haya1010/esp32-c3-compact-dip-led/ORDER_REVIEW.md

# JLCPCB注文前レビュー

## 現在の検証結果

- KiCad ERC: 0エラー、0警告
- KiCad PCB DRC: 0違反、未配線0
- 2層、50 × 78 mm
- ESP32アンテナ下・前方は両面銅箔/配線/ビア禁止領域
- USB-C D+/D-は意図的に未接続
- USB-C CC1/CC2は各5.1 kΩでGND終端
- DC入力からLED+までは太配線、MOSFETはローサイド

## 注文画面で必ず確認する項目

1. 2層、FR-4 1.6 mm、1 oz銅、外形50 × 78 mm。
2. SMT実装面はTopのみ。
3. BOM/CPL照合画面でU1、U2、J2、Q1、L1の向きを画像と比較。
4. LCSC在庫切れ時に自動代替を承認しない。電圧・パッケージ・ピン互換を再確認。
5. Q1 RJP020N06T100（C703680）はNRND。在庫がなければ勝手に別MOSFETへ置換せず再設計。
6. L1はC49009349。22µH、定格2A、飽和3.1A、4.1×4.1mmであることを確認。
7. J1、J3、J4、JH1、JH2、JP1、JP2は手作業対象。
8. 最初は5枚、Economic PCBA、部品実装2枚程度で試作を推奨。

## 費用の目安

L1自体は低数量時で概ね **40～50円/個** の低価格品です。ただしExtended部品なので、部品単価とは別に実装時の固定費が発生する場合があります。

JLCPCBの在庫・セットアップ料金・送料で大きく変わります。5枚基板＋片面PCBA＋日本への通常配送で、概ね **4,000～8,000円** を想定してください。10～20枚に増やすと固定費が分散し、1枚1,000円未満を狙いやすくなります。DCジャック、端子台、ピンヘッダ、ACアダプタ、LEDテープは別です。正確な金額はアップロード後の見積画面でのみ確定します。

## 初回通電手順

1. JP1をDC側、JP2をREG側の片側だけ接続。
2. LEDとA105をまだ接続しない。
3. 電流制限を100 mA程度にした5 V電源をDCジャックへ接続。
4. JH1-2とGND間が約3.3 Vであることを確認。
5. 異常発熱がないことを確認後、ESP32、A105、LEDを順に試す。

この設計は試作未実機確認です。量産前に必ず初版を実測してください。
