haya1010/esp32-c3-compact-dip-led/previews/schematic.pdf

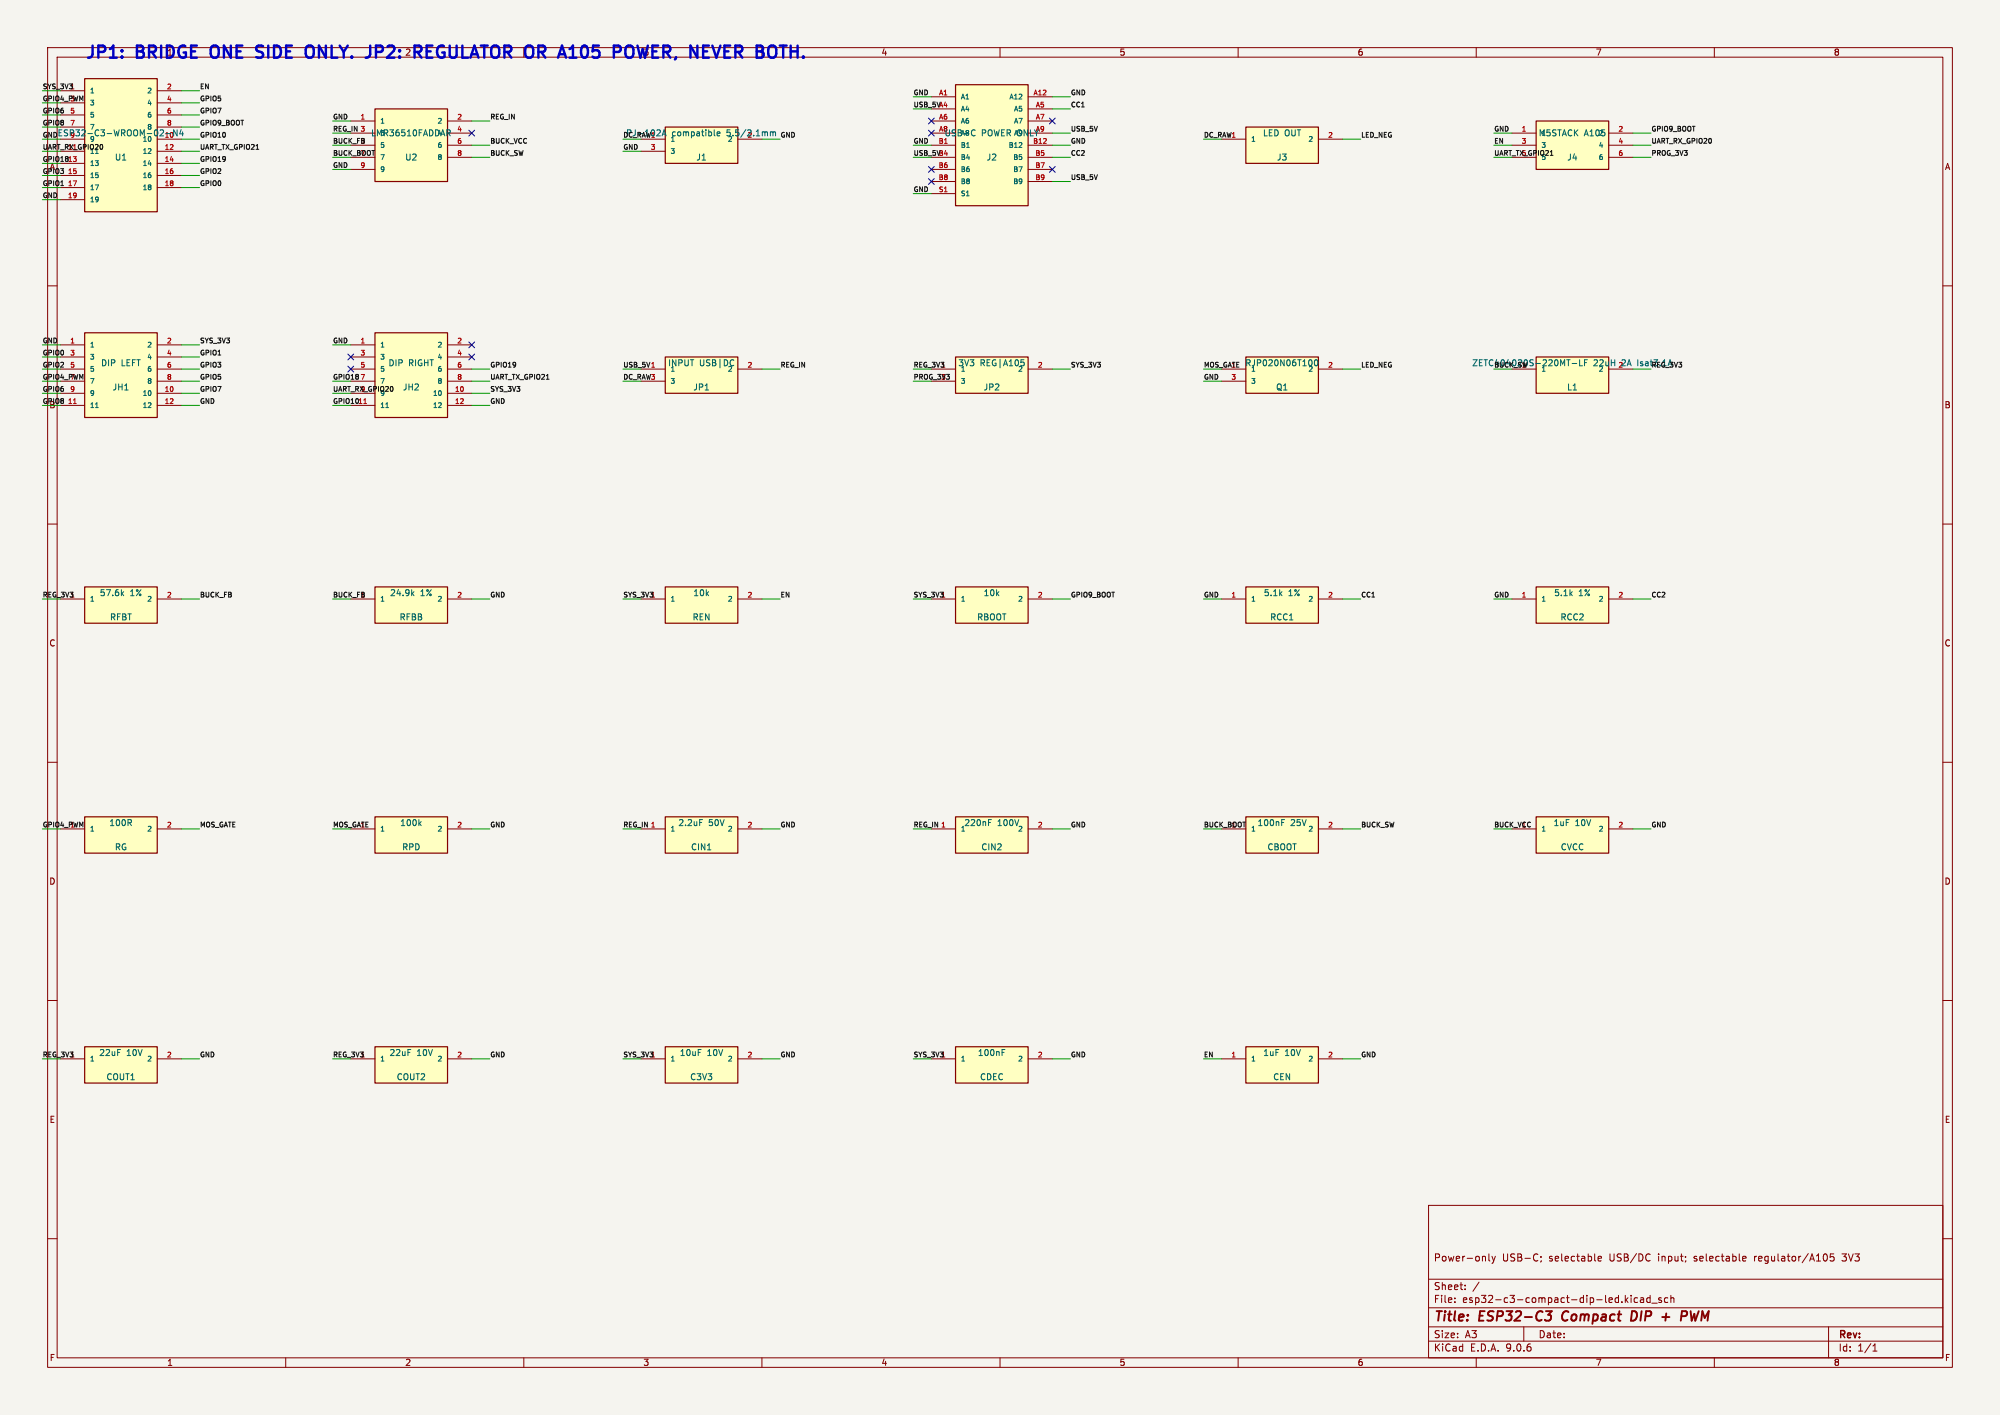
[picture p2: page 1]

UART_TX_GPIO21 JP1: BRIDGE ONE SIDE ONLY. JP2: REGULATOR OR A105 POWER, NEVER BOTH.
