haya1010/esp32-c3-compact-dip-led/esp32-c3-compact-dip-led.kicad_pcb

## KiCad design esp32-c3-compact-dip-led.kicad_pcb (2026-10-18)

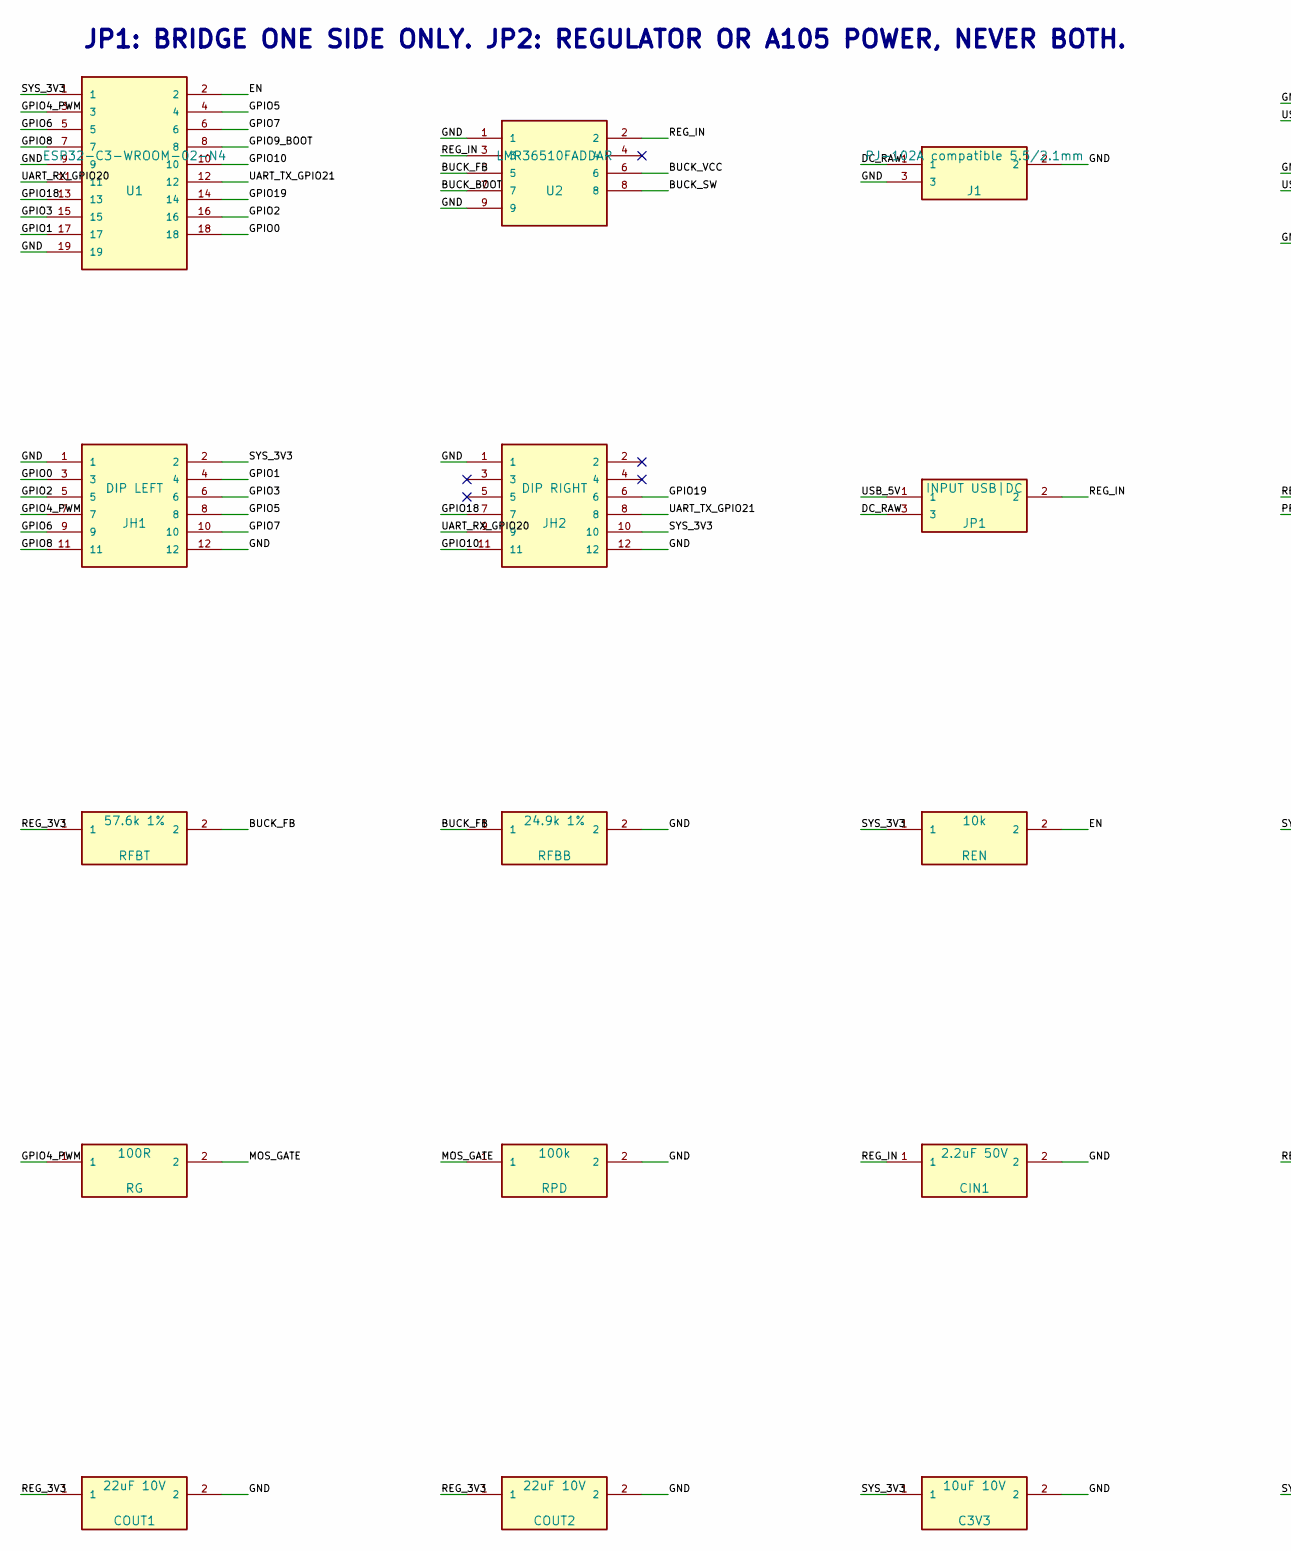
[picture p3: schematic esp32-c3-compact-dip-led.kicad_sch, ESP32-C3 Compact DIP + PWM, part in row 1, column 1]

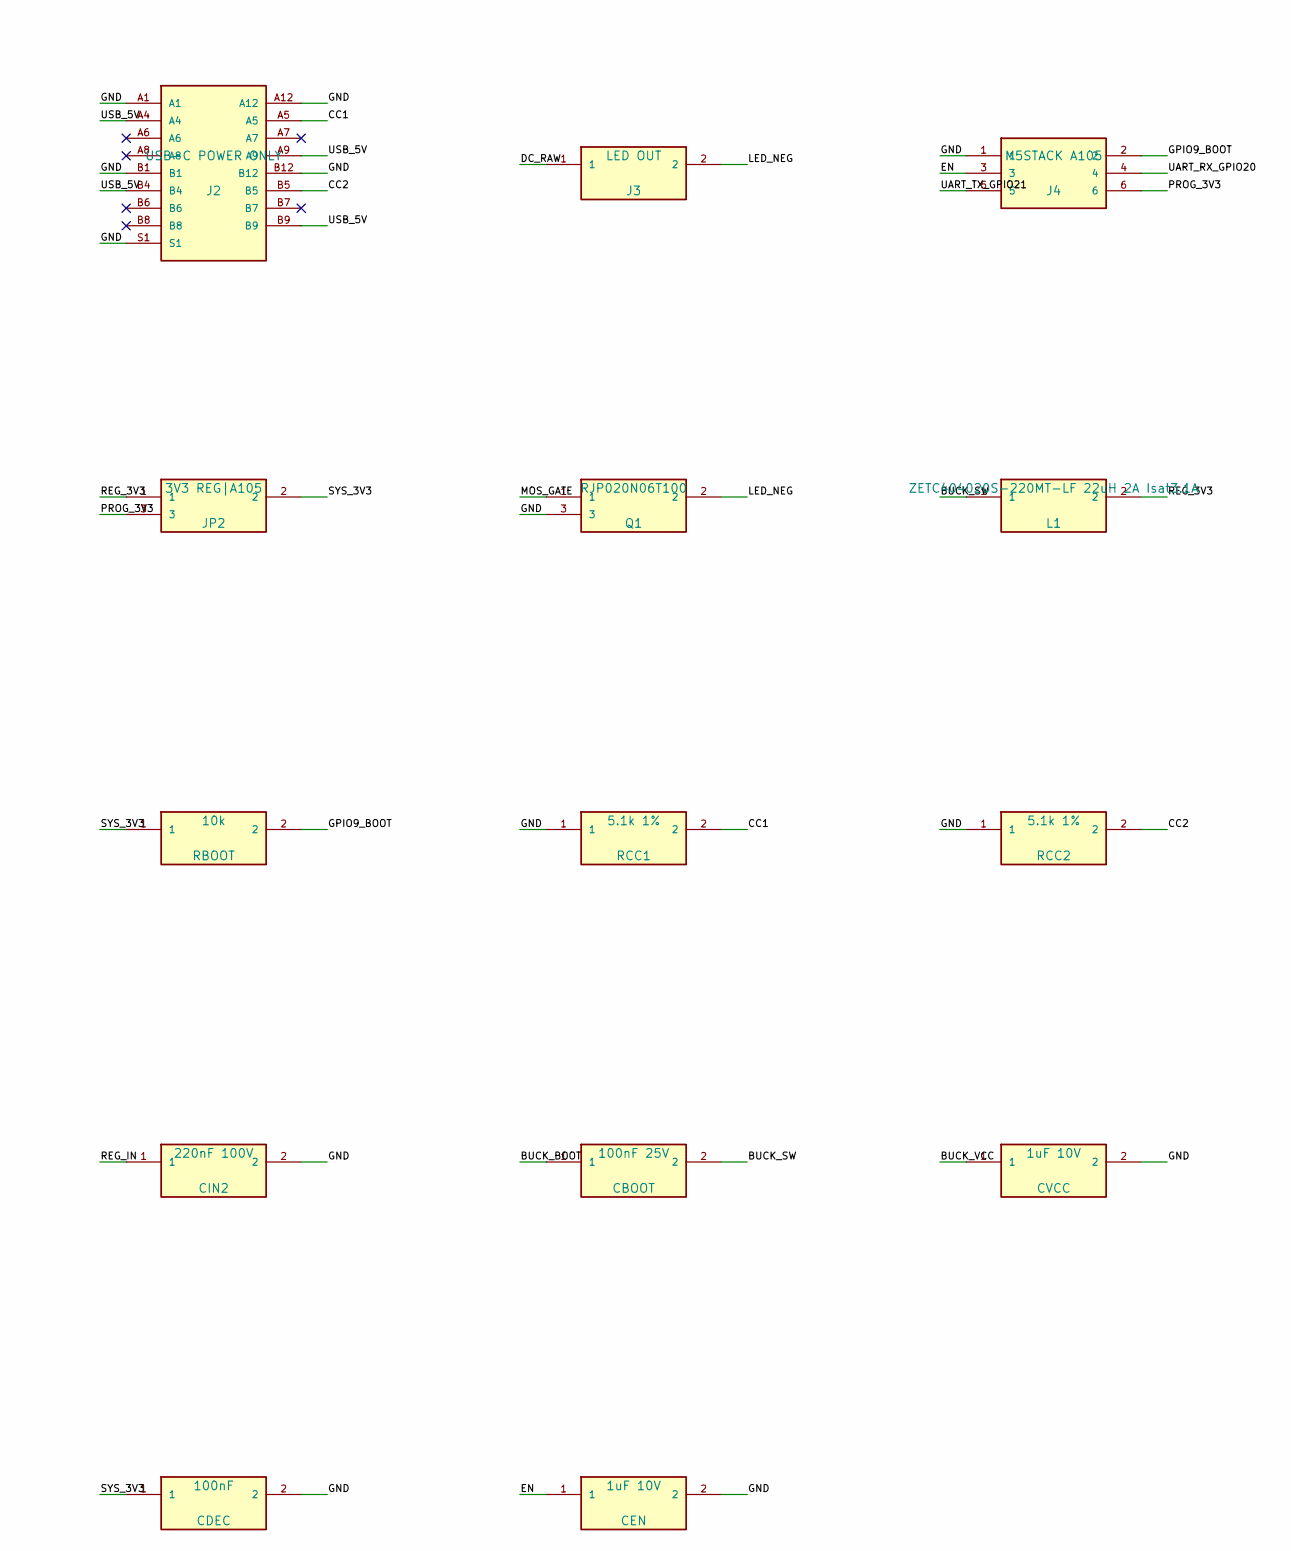
[picture p4: schematic esp32-c3-compact-dip-led.kicad_sch, ESP32-C3 Compact DIP + PWM, part in row 1, column 2]

Parts:
C3V3: 10uF 10V
CBOOT: 100nF 25V
CDEC: 100nF
CEN: 1uF 10V
CIN1: 2.2uF 50V
CIN2: 220nF 100V
COUT1, COUT2: 22uF 10V
CVCC: 1uF 10V
J1: PJ-102A compatible 5.5/2.1mm
J2: USB-C POWER ONLY
J3: LED OUT
J4: M5STACK A105
JH1: DIP LEFT
JH2: DIP RIGHT
JP1: INPUT USB|DC
JP2: 3V3 REG|A105
L1: ZETC404020S-220MT-LF 22uH 2A Isat3.1A
Q1: RJP020N06T100
RBOOT: 10k
RCC1, RCC2: 5.1k 1%
REN: 10k
RFBB: 24.9k 1%
RFBT: 57.6k 1%
RG: 100R
RPD: 100k
U1: ESP32-C3-WROOM-02-N4
U2: LMR36510FADDAR

Connections:
BUCK_BOOT: CBOOT.1, U2.7
BUCK_FB: RFBB.1, RFBT.2, U2.5
BUCK_SW: CBOOT.2, L1.1, U2.8
BUCK_VCC: CVCC.1, U2.6
CC1: J2.A5, RCC1.2
CC2: J2.B5, RCC2.2
DC_RAW: J1.1, J3.1, JP1.3
EN: CEN.1, J4.3, REN.2, U1.2
GND: C3V3.2, CDEC.2, CEN.2, CIN1.2, CIN2.2, COUT1.2, COUT2.2, CVCC.2, J1.2, J1.3, J2.A1, J2.A12, J2.B1, J2.B12, J2.S1, J4.1, JH1.1, JH1.12, JH2.1, JH2.12, Q1.3, RCC1.1, RCC2.1, RFBB.2, RPD.2, U1.9, U1.19, U2.1, U2.9
GPIO0: JH1.3, U1.18
GPIO1: JH1.4, U1.17
GPIO2: JH1.5, U1.16
GPIO3: JH1.6, U1.15
GPIO4_PWM: JH1.7, RG.1, U1.3
GPIO5: JH1.8, U1.4
GPIO6: JH1.9, U1.5
GPIO7: JH1.10, U1.6
GPIO8: JH1.11, U1.7
GPIO9_BOOT: J4.2, RBOOT.2, U1.8
GPIO10: JH2.11, U1.10
GPIO18: JH2.7, U1.13
GPIO19: JH2.6, U1.14
LED_NEG: J3.2, Q1.2
MOS_GATE: Q1.1, RG.2, RPD.1
PROG_3V3: J4.6, JP2.3
REG_3V3: COUT1.1, COUT2.1, JP2.1, L1.2, RFBT.1
REG_IN: CIN1.1, CIN2.1, JP1.2, U2.2, U2.3
SYS_3V3: C3V3.1, CDEC.1, JH1.2, JH2.10, JP2.2, RBOOT.1, REN.1, U1.1
UART_RX_GPIO20: J4.4, JH2.9, U1.11
UART_TX_GPIO21: J4.5, JH2.8, U1.12
USB_5V: J2.A4, J2.A9, J2.B4, J2.B9, JP1.1

Notes on the sheet:
JP1: BRIDGE ONE SIDE ONLY. JP2: REGULATOR OR A105 POWER, NEVER BOTH.

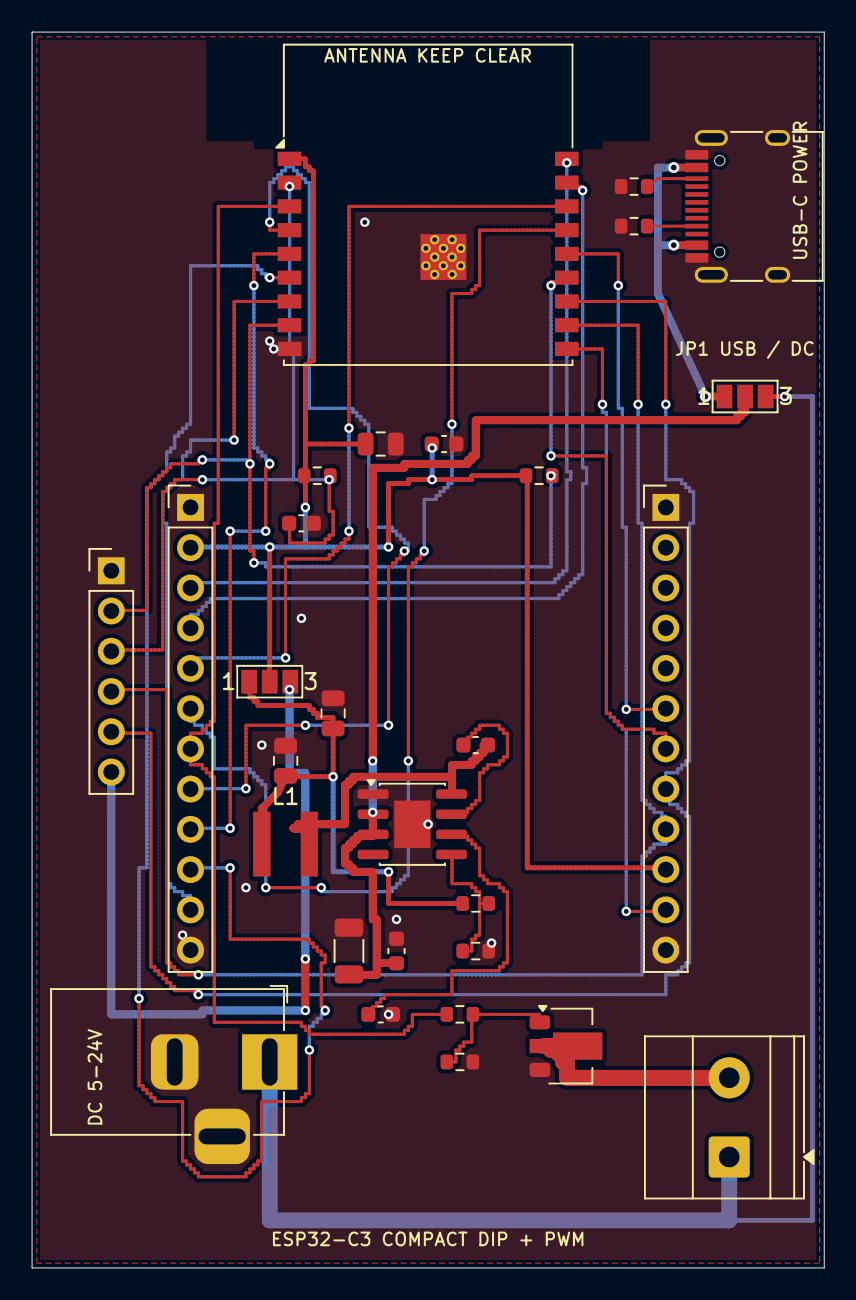
[picture p5: board esp32-c3-compact-dip-led.kicad_pcb from above]

Board: 2 copper layers, 50.0 x 78.0 mm, 29 parts (0 on the bottom side), 31 nets.
