haya1010/esp32-c3-compact-dip-led/docs/POWER_AND_JUMPER_GUIDE_JA.md

# 電源・ジャンパ・保護回路の説明

## なぜUSB-CもDCも同じ3.3 V降圧回路へ入れられるのか

USB-Cは通常の充電器から5 Vだけを受け、DCジャックは5/12/24 Vを受けます。JP1でどちらか一方を選び、最大65 V入力対応の降圧ICへ入れるので、どちらも同じ回路で3.3 Vにできます。USB-Cの信号線は使いません。

CC1/CC2の5.1 kΩは、USB-C充電器に「この基板は電力を受ける側です」と知らせるための抵抗です。通信や急速充電用ではなく、C-to-Cケーブルでも5 Vを出してもらうために必要です。

## JP1: 入力選択

- 1-2をはんだ接続: USB-C 5 V → 3.3 V降圧回路
- 2-3をはんだ接続: DC 5～24 V → 3.3 V降圧回路
- 両側同時は不可

自動ORingを省略したため、部品点数・電圧降下・基板面積は減りました。その代わり、USB-CとDCを同時に挿さない運用が必要です。

## JP2: ESP32の3.3 V選択

- 1-2をはんだ接続: 基板内の降圧回路からESP32へ給電
- 2-3をはんだ接続: A105からESP32へ給電
- 両側同時は不可

A105で書き込みやシリアルログ確認ができます。A105はUART書き込み器なので、JTAGの停止・ステップ実行とは別物です。

## ヒューズや逆接保護を省略した理由

ユーザーの希望に合わせ、基板を小さく簡単にするため省略しています。これは「不要」という意味ではなく、保護を外部電源と使い方に任せる設計です。

- 必ず電流制限のある認証済みACアダプタを使う
- DCはセンタープラスだけを使う
- LEDテープの定格に合った電源と配線を使う
- 大電流LEDには電源出力直後のインラインヒューズを推奨
- 初回通電は電流制限付き電源で、3.3 Vを測ってからESP32を動かす

## MOSFETと出力

GPIO4がMOSFETのゲートを駆動します。J3のLED+はDC入力へ直結、LED-はMOSFETを通ってGNDへ落ちます。これは一般的なローサイドPWMです。LEDテープの電流はESP32や降圧回路を通りません。

採用したRJP020N06は60 V・2 A級ですが、廃止予定品（NRND）で、基板の放熱条件もあるため、初版では連続2 Aを保証しません。まず0.5～1 A程度で温度を確認し、必要なら次版で現行品へ置換してください。
