haya1010/esp32-c3-compact-dip-led/(commit log)

2026-10-18 Initial compact ESP32-C3 DIP LED controller design
    [BOM-JLCPCB.csv, BOM-full.csv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]
2026-10-18 Use lower-cost 2A buck inductor
    [BOM-JLCPCB.csv, BOM-full.csv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]
